DE9856/WRO2026/media/photos/car.png

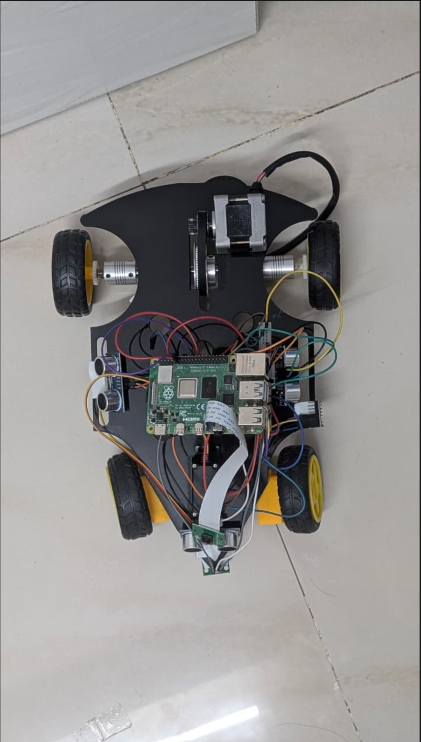
media/photos/car.png
