DE9856/WRO2026/media/photos/camera-processing.png

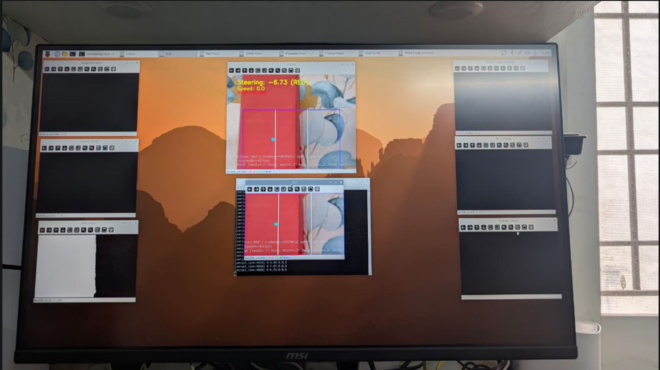
media/photos/camera-processing.png
