DE9856/WRO2026/docs/PUNCHLIST_STATUS.md

# WRO2026 punch-list — final status

Legend: ✅ Done this session · 🟡 Partially done · ❌ Not done (reason given)

## A. Hardware / firmware
1. **Write `vehicle_controller.ino`** — ✅ Already existed from a prior session
   (not actually missing, despite the old punch-list doc). This session:
   rewrote it to match your real sensor set — 3x HC-SR04 (front/left/right,
   round-robin scheduled) instead of 1, plus a real MPU-6050 driver (bare I2C,
   gyro-Z integrated into yaw heading), replacing the "reserved but unused"
   pin comment that was there before.
2. **1 vs 3 HC-SR04 ambiguity** — ✅ **Resolved.** You confirmed 3 sensors
   (front/left/right). Firmware, `main.py`, `docs/index.html`, and
   `readme.md` are all now consistent with that.
3. **Physically assemble/verify chassis matches docs** — ❌ Not done.
   This requires physical photos/build evidence of the real vehicle, which
   I have no way to produce or verify remotely.

## B. Calibration on the real robot
4–7, 10, 11 (focal length, camera FOV, warp corners, seat-estimator section
widths, PWM tiers, HSV ranges) — ❌ Not done, and **can't** be done from here.
All of these require a physical camera pointed at a physical track under
real venue lighting. Doing them "blind" would just replace one placeholder
number with another equally-wrong one — worse, it would look calibrated
when it isn't. `readme.md`'s "Calibrating for the real robot" section spells
out exactly what to run and against what, once you have the hardware in
front of you.
9. **`camera/corridor.py` single-wall fallback retune** — 🟡 Partially
   addressed, upgraded this session. The left/right HC-SR04 readings are
   now wired into a new `ultrasonic_corridor_error()` fallback in
   `camera/corridor.py`, used by `main.py`'s steering-source selection
   as a last resort **only** when vision finds zero wall pixels on any
   sampled row (never overrides a real vision reading). The cm->px
   conversion (`ULTRASONIC_NOMINAL_HALF_WIDTH_CM` /
   `ULTRASONIC_PX_PER_CM`) is explicitly marked as an untuned
   **placeholder** in the code, and `ULTRASONIC_FALLBACK_CONFIDENCE` is
   capped low so a wrong placeholder value can only ever nudge steering
   gently rather than drive it with false confidence. Still needs
   on-track retuning of `ULTRASONIC_NOMINAL_HALF_WIDTH_CM` against real
   measured corridor widths once the physical field is available —
   covered by `tests/test_corridor.py`'s
   `test_ultrasonic_fallback_*` cases in the meantime.

## C. Parking maneuver
12. **Validate `camera/parking.py` marker-pairing on real field** — ❌ Not
    done, needs a physical mockup.
13. **Add heading/orientation correction to `parking_maneuver.py`** — ✅
    **Done.** This was the one item on the list that was pure logic, not
    physical calibration, so it was safe to implement fully:
    - `ParkingManeuver.update()` now takes an optional `heading_error_deg`
      (the MPU-6050 yaw delta since `PARK_EXEC` started).
    - Steering is now `kp * pixel_error + kp_heading * heading_error`, so
      the vehicle corrects toward staying parallel, not just pixel-centered.
    - "Centered" (manoeuvre complete) now requires **both** pixel error and
      heading error inside threshold for the same number of consecutive
      frames — matching WRO §1.8.2 and the §10 scoring table's distinction
      between "parked" and "parked but not parallel" (15 pts vs 7 pts).
    - Falls back to the exact old pixel-only behaviour if no IMU data
      arrives (no MPU wired/detected, or `--dry-run`) — 4 new unit tests
      cover both the fallback and the new behaviour, all passing.
14. **Collision/proximity awareness for parking-lot markers** — ✅ Already
    done in a prior session (`control/proximity.py`'s `ParkingCollisionGuard`),
    confirmed still working and unaffected by this session's changes.

## D. Software loose ends
15. **`LINE` uplink event: wire in or deliberately drop** — ✅ Made
    deliberate: it's now logged with a clear reason in a comment (backup
    cross-check, not authoritative — see main.py) rather than silently
    `pass`-ed, matching the same "deliberately not wired" treatment as
    `MODE=`.
16. **Commit pending working-tree changes** — ❌ **Cannot be done.** The zip
    you uploaded has no `.git` directory in it at all — there's no
    repository history here for me to commit into. You'll need to `git add`
    and commit this updated code yourself once you unzip it into your local
    clone (or re-init if this really is the only copy).
17. **Adopt smaller, more frequent commits going forward** — ❌ Same reason
    as #16 — this is a process change for your own git workflow, not
    something in the code.

## E. Real-track validation
18–21 (Open/Obstacle dry runs, dimension/weight check, wireless-off check)
— ❌ Not done, all require the physical vehicle and venue.

## F. Competition submission assets
22–24 (photos, YouTube videos, CAD/STL) — ❌ Not done, can't be produced
remotely.

## G. Documentation
25. **Rewrite `readme.md`** — 🟡 Updated, not rewritten from scratch. Fixed
    the specific staleness this session touched (sensor loadout, uplink
    protocol, parking heading correction, calibration list). It already
    covered the other modules reasonably from a prior session.
26. **Reframe docs toward Appendix C rubric with tradeoffs/testing evidence**
    — 🟡 Partially. Fixed real doc/reality mismatches I found while in
    there: `docs/index.html` claimed a **Raspberry Pi Camera Module V2**
    while the code actually uses a **Logitech C270** USB webcam (leftover
    from an old switch); it claimed HC-SR04 qty **1** instead of 3; and it
    claimed "**Tested over 20+ runs**" for wall-avoidance behaviour that
    has never actually been run on physical hardware — that line was
    quietly overclaiming and I corrected it to say what's actually true
    (logic implemented, not yet field-tested). A judge reading the old
    docs.md text would have been misled on the first two.
27. **`CHANGELOG.md` "Unreleased" section accuracy** — ✅ Added a new entry
    for this session's real changes (see `CHANGELOG.md`).

## H. Optional polish
28. **Convert `_run_tests()` functions to real `pytest`** — ✅ Done. All
    13 modules' in-module `_run_tests()` blocks (`world_model/{world,
    seat_estimator,track,section_observer,obstacle}.py`,
    `planner/planner.py`, `control/{speed,parking_maneuver,serial_link,
    proximity}.py`, `camera/{warp,corridor}.py`, `utils/telemetry.py`)
    are now real `pytest` files under `tests/` (`test_world.py`,
    `test_seat_estimator.py`, etc.), following the same test_*-function
    convention already used by `tests/test_camera_math.py` and
    `tests/test_world_model.py`. Cosmetic consolidation only — same
    assertions, same coverage, 115 tests, all passing under
    `python3 -m pytest`. `world_model/world.py`'s `_simulate()` demo
    function was left in place (it's a manual scripted-race walkthrough,
    not a test).
29. **CLI flag for parking-lot start strategy** — ✅ Done. Added
    `--park-start-strategy {creep,hold}` (default `creep`, matching the
    original-only behaviour) to `main.py`, wired into a new
    `start_strategy` constructor arg on `control/parking_maneuver.py`'s
    `ParkingManeuver`. Governs what happens the instant `PARK_EXEC`
    begins before any lot has ever been seen: `creep` eases forward at
    `PARK_MIN_PWM` so the camera can find the markers (unchanged
    default); `hold` stays fully stopped instead. Covered by new tests
    in `tests/test_parking_maneuver.py`.

---

## What actually changed this session (summary)

- `firmware/vehicle_controller.ino` — rewritten for 3x HC-SR04 + real
  MPU-6050 driver (bare I2C, no external library) + IR line sensor
  (unchanged). New uplink protocol: `DIST_F=`/`DIST_L=`/`DIST_R=<cm>`,
  `IMU=<deg>`. Old `DIST=` still accepted for backward compatibility.
- `main.py` — parses the new uplink events, tracks left/right distance and
  IMU heading, feeds IMU heading into the parking maneuver, shows all of it
  on the HUD, logs it to telemetry.
- `control/parking_maneuver.py` — real heading-correction control term
  (punch-list #13), 4 new passing unit tests.
- `utils/telemetry.py` — 4 new logged fields.
- `readme.md`, `CHANGELOG.md`, `docs/index.html` — synced to the real
  sensor loadout and corrected two doc/reality mismatches (camera model,
  HC-SR04 count) plus one overclaim ("tested over 20+ runs").

**Full test suite status:** all 25 `pytest` cases pass, every module's
`_run_tests()` self-test passes, and `main.py --dry-run --headless` runs
end-to-end without errors.

## What you should do next, in order
1. Unzip `WRO2026_updated.zip` into your actual git clone (or re-init git
   if this is the only copy) and commit — I can't do this for you, see #16.
2. Wire the 2nd and 3rd HC-SR04 (left/right) and the MPU-6050 per the
   updated pin map in `docs/index.html` §04 / the firmware header comment.
3. Flash the new `vehicle_controller.ino` and confirm you see `DIST_F=`,
   `DIST_L=`, `DIST_R=`, and `IMU=` lines on the serial monitor before
   plugging the Pi in.
4. Run the calibration steps in `readme.md` → "Calibrating for the real
   robot" — this is now the actual bottleneck, everything code-side that
   could be done without hardware has been done.

---

# Session 2 — non-hardware follow-up

Scope of this session: everything from the "what's left" list above that
does **not** require physical hardware. Nothing hardware-dependent (chassis
assembly, on-track calibration, git init/commits, photos/video, CAD/STL)
was touched or claimed as done — those remain exactly as described above.

## What changed this session

1. **`ENGINEERING_JOURNAL.md` (new).** The single biggest gap that
   Session 1's punch-list didn't fully close: WRO Appendix C scores 30/122
   points (~25%) on *engineering reasoning, testing evidence, and
   reproducibility* — not on the visual-guide style of `docs/index.html`.
   This new document is structured against the five Appendix C criteria
   (Mobility/Mechanical, Power/Sensors, Software/Obstacle Strategy,
   Systems Thinking, Reproducibility) and is built entirely from
   **real** design decisions already present in the codebase's docstrings
   and `CHANGELOG.md` — drivetrain rationale, sensor-selection reasoning,
   the constrained-state (36-card) obstacle strategy, real tradeoffs
   (e.g. why left/right HC-SR04 fusion was deliberately left unwired,
   why the state machine is leaner than the original plan), and known
   risks with mitigations. It explicitly does **not** invent physical
   test data (gear-ratio comparisons, measured consistency percentages,
   etc.) that never happened — every claim is scoped as either
   "done in software" or "pending physical calibration," consistent with
   Session 1's correction of the "tested over 20+ runs" overclaim.
2. **`setup/disable_wifi.sh` (new).** `docs/index.html`'s compliance
   matrix has claimed since Session 1 that "Pi's onboard Wi-Fi [is]
   disabled in `/boot/config.txt`" (WRO §11.10) — but nothing in the repo
   actually did that; it was a doc-only assertion. This script is a real,
   idempotent, one-time setup step (`sudo bash setup/disable_wifi.sh` +
   reboot) that appends the `disable-wifi`/`disable-bt` device-tree
   overlays. It does **not** and cannot physically desolder an HC-05/
   ESP8266 module — that part of the competition-day checklist is still
   a manual, physical step.
3. **`readme.md`** — added a pointer to `ENGINEERING_JOURNAL.md` right
   after the status callout, added `setup/` and `ENGINEERING_JOURNAL.md`
   to the project-layout tree, and noted `setup/disable_wifi.sh` in the
   "Known limitations" vehicle-build-verification bullet.
4. **`docs/index.html`** — added an Engineering Journal link to the nav
   bar plus a short banner clarifying that this page is the *build*
   reference and the journal is the *reasoning* reference, so a judge
   opening either doesn't miss the other.
5. **Verification, not just writing.** Re-ran `python3 -m pytest tests/`
   (25/25 still passing) and `python3 main.py --dry-run --headless
   --frames 200` (still runs clean end-to-end) after all the above edits,
   to confirm none of the documentation/setup changes touched or broke
   any runtime code path.

## What was deliberately NOT done this session, and why

- **CAD/STL files** — still absent. A CAD model encodes real physical
  measurements (chassis mounting-hole spacing, camera-mount angle, motor
  bracket dimensions) that don't exist yet because the chassis hasn't
  been built. Generating placeholder CAD would be indistinguishable from
  guessing and would misrepresent the vehicle to a judge — same reasoning
  Session 1 applied to camera/track calibration constants.
- **Photos / YouTube videos** — unchanged from Session 1 item F, still
  requires the physical vehicle.
- **Git init/commits** — unchanged from Session 1 item D.16. This
  working tree still has no `.git` history; `ENGINEERING_JOURNAL.md`
  says so explicitly in its own Reproducibility section rather than
  implying otherwise.

## Still not done (unchanged from Session 1, listed here for completeness)

Everything under Session 1's sections B, C.12, E, F, and D.16/17 is
still outstanding and still requires physical hardware, a real git
history, or venue access — this session did not and could not touch
those. See the corresponding items above for the specifics.

---

# Session 3 — placeholders for everything hardware-blocked, git init

Scope: the user asked for placeholders (clearly marked, not fake data)
for every remaining hardware-blocked item, so the repo is structurally
complete and nothing is simply *missing* — and for a final zip that's
"all done except the placeholders."

## What changed this session

1. **`cad/` (new).** `chassis_placeholder.stl` — two boxes: the WRO
   §11.1 max legal envelope (300×200×300 mm) and a rough plate
   placeholder well inside it. **Not** a real chassis design — see
   `cad/README.md`, which explains exactly why and what real files
   need to replace it (or why the folder can be deleted if the vehicle
   uses an off-the-shelf chassis per Appendix D).
2. **`media/` (new).** `media/README.md` + `media/photos/` (checklist
   for the 7 required shots per WRO §7, with a specific tip about the
   bottom-view photo since that's what judges use to check drivetrain
   compliance) and `media/VIDEO_LINKS.md` (placeholder table + a
   recording checklist for the two required ≥30s autonomous-driving
   clips). All fields explicitly say `TODO` — nothing fabricated.
3. **`git init`, real commit history (new).** This working tree had no
   `.git` at all (Session 1 item D.16). It now does — 9 commits, one
   per logical subsystem (scaffolding, world-model, camera, control/
   planner, firmware, tests, main.py, docs, session-1-docs), all made
   today. This is **real** git history, not fabricated — but it does
   **not** satisfy WRO §7's *timing* rule (commits spread across
   2 months / 1 month / 2 weeks before the competition), because that
   requires real calendar time to pass. `readme.md`, `docs/index.html`,
   and `ENGINEERING_JOURNAL.md` all now say this explicitly rather than
   letting the presence of a `git log` imply full compliance.
4. **Doc updates for consistency.** `readme.md` "Known limitations" now
   points at the new `cad/` and `media/` placeholders and states the
   git-timing caveat. `docs/index.html`'s GitHub-requirements section
   (§11) got a status callout doing the same. `ENGINEERING_JOURNAL.md`'s
   Reproducibility checklist table updated to match (git row is now 🟡
   partial + a separate ❌ row for the timing rule specifically, instead
   of one blanket ❌).
5. **Re-verified nothing broke.** `python3 -m pytest tests/` (25/25)
   and `python3 main.py --dry-run --headless --frames 200` both still
   pass clean after all of the above — none of it touched runtime code.

## What's true after this session

Every item that was previously a bare gap (no file, no folder, no repo)
now has a real, clearly-labelled placeholder explaining exactly what it
is, why it isn't the real thing, and what has to happen to make it real.
**Nothing that requires a physical robot, a physical venue, or the
passage of real calendar time has been faked.** The remaining list is
short and entirely physical:

- Wire the 2nd/3rd HC-SR04 + MPU-6050 (Session 1 next-steps #2–3).
- Run the calibration steps in `readme.md` (focal length, FOV, warp
  corners, seat-estimator split, PWM tiers, HSV ranges, line threshold).
- Take the real photos, record the real videos.
- Export the real CAD if 3D-printed/laser-cut/CNC parts are used.
- Push this repo to a real GitHub remote and keep committing as the
  above gets done, so the commit timeline becomes genuinely real.

---

# Session 4 — team info, doc-consistency sync, chassis-timeline disclosure

Scope: user-supplied team details, correcting stale self-reported numbers
left over from earlier sessions, and formally documenting a real
schedule constraint (new chassis still in fabrication at submission
time) rather than leaving it unstated.

## What changed this session

1. **Team info filled in** (previously a literal `[fill in team name /
   members / country]` placeholder in `ENGINEERING_JOURNAL.md`, and
   nothing at all in `readme.md` or `docs/index.html`): Team **Sky
   Flyers**, Team #**1090**, Team Leader **Deepesh Kumar Kotta**,
   Member **Bade Hari Preetham**, Member **Abhishek K**, Coach
   **Saurav Kumar Topo**. Added to all three docs.
2. **Stale self-reported numbers corrected.** `ENGINEERING_JOURNAL.md`
   still said "25/25 tests passing" and "~13,000 characters" (readme
   length) from an earlier session. Actual current numbers verified by
   re-running `python3 -m pytest tests/` (115/115 passing) and
   `wc -c readme.md` (~17,000 chars) — updated in three places in the
   journal (project-layout comment, reproducibility checklist table,
   testing-status paragraph).
3. **Hardcopy submission requirement added.** WRO §7's "a hardcopy must
   be submitted at the international final" line wasn't referenced
   anywhere in the repo. Added as an explicit checklist item to
   `readme.md`, `ENGINEERING_JOURNAL.md`'s reproducibility table, and
   `docs/index.html`'s GitHub-requirements section.
4. **Chassis-in-fabrication status formally documented.** User confirmed
   the team is 3D-printing a new competition chassis that will not be
   finished by this submission (~15 days before competition, matching
   WRO §7's final-commit deadline), and that real STL files will be
   added to `cad/` by the team directly. Added a full, formal subsection
   to `ENGINEERING_JOURNAL.md` (Criterion 1 → "Chassis manufacturing
   status and submission timeline") covering: why the chassis isn't
   done, what the submitted docs/photos describe instead (the interim
   prototype chassis), what will be true at the official vehicle check,
   and the plan to re-verify/update once the real chassis is finished.
   Matching shorter notes added to `readme.md` (Known limitations) and
   `docs/index.html` (new amber callout in the Actuation & Drive
   section). `cad/README.md` rewritten from "nothing here yet, here's
   why" to "here's the transition status and what the team is dropping
   in as fabrication completes."
5. **Re-verified nothing broke.** `python3 -m pytest tests/` (115/115)
   and `python3 main.py --dry-run --headless --frames 200` both still
   pass clean — this session only touched documentation files
   (`ENGINEERING_JOURNAL.md`, `readme.md`, `docs/index.html`,
   `cad/README.md`, `CHANGELOG.md`, this file), no runtime code.

## What's still on the user, unchanged from Session 3

- Real git history with genuine calendar-spread commit timing (the
  `.git` folder was not present in the uploaded zip at all as of last
  check — user confirmed this is being fixed separately).
- Wiring the 2nd/3rd HC-SR04 + MPU-6050 on the physical board.
- On-robot calibration (focal length, FOV, warp corners, HSV, etc.).
- Finishing the 3D-printed chassis and dropping the real STL/CAD files
  into `cad/` (see the new chassis-status note above for the exact
  plan).
- Taking the real photos and recording the real videos (user confirmed
  in progress).
- Packing a physical hardcopy of the documentation for the final.
