DE9856/WRO2026/cad/Servo Arm.stl

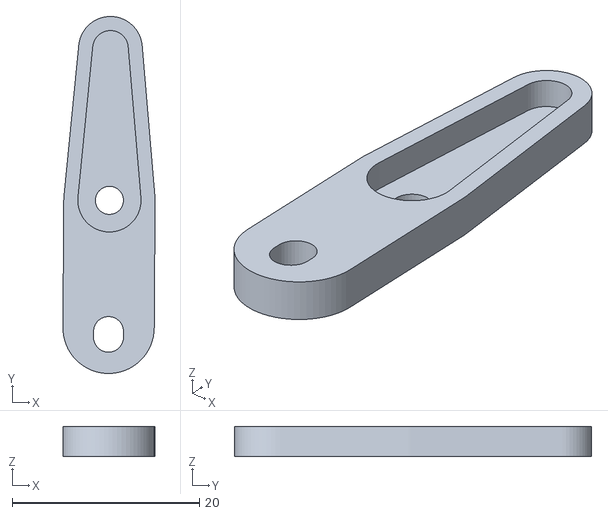
[picture p3: CAD file, 2026-08-12]
cad/Servo Arm.stl
9.84 x 38.1 x 3.25
