DE9856/WRO2026/cad/Chassis_Empty.stl

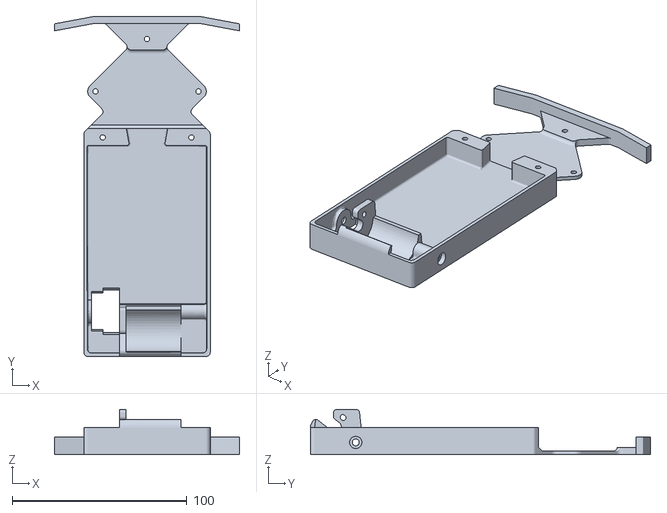
[picture p4: CAD file, 2026-08-12]
cad/Chassis_Empty.stl
106.0 x 195.0 x 25.9
