DE9856/WRO2026/cad/Top Brace.stl

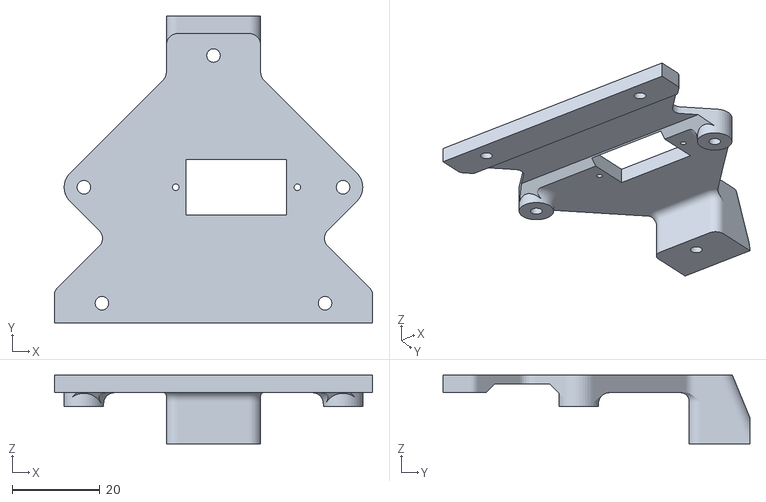
[picture p5: CAD file, 2026-08-12]
cad/Top Brace.stl
72.5 x 69.9 x 15.7
