DE9856/WRO2026/cad/Front Axel Left.stl

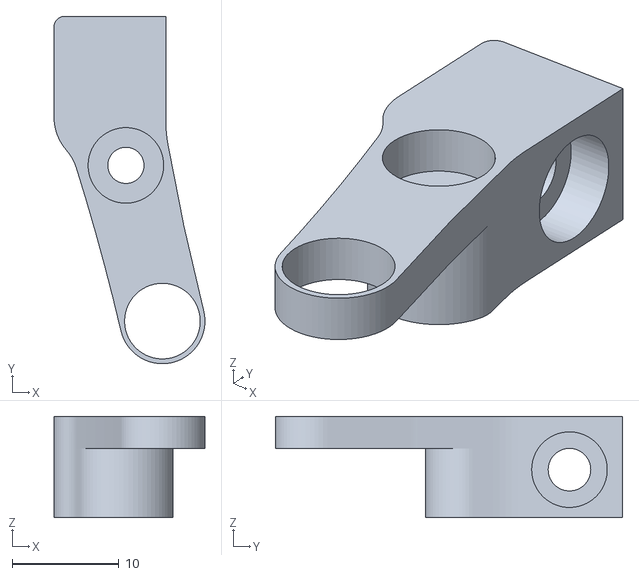
[picture p6: CAD file, 2026-08-12]
cad/Front Axel Left.stl
14.2 x 32.6 x 9.50
