DE9856/WRO2026/cad/Ackerman.stl

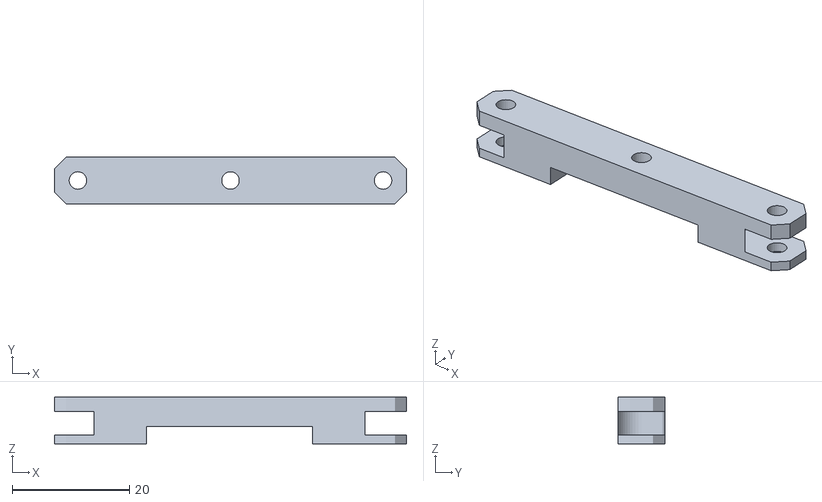
[picture p7: CAD file, 2026-08-12]
cad/Ackerman.stl
60.2 x 8.00 x 8.00
