DE9856/WRO2026/(list of files, cad)

Other CAD files:
cad/Front Axel Right.stl
