DE9856/WRO2026/(commit log)

2026-08-12 Improved Documentation and finished Code
    [Ackerman.stl, Chassis_Empty.stl, Front Axel Left.stl, Front Axel Right.stl, Servo Arm.stl, Top Brace.stl]
2026-08-12 Revise README with updated project details and goals
    Updated project title and team information, added badges, and revised project goals and current development status.
